ernestomas/SILAR_V1/Planos/03SILAR02.pdf

PARTS LIST
ITEM | QTY | PART NUMBER
1 | 1 | Columna
2 | 2 | Bastidor
3 | 1 | PataBastidor1
4 | 1 | PataBastidor2
5 | 1 | BaseMotorSuperior
6 | 2 | Motor
7 | 1 | Husillo
8 | 1 | GuiaHusillo
9 | 1 | TuercaHusillo
10 | 1 | Deslizador
11 | 1 | BaseEjeDisco
12 | 1 | Disco
13 | 1 | BrazoSoporte
14 | 1 | SeparadorDisco
15 | 1 | BaseMotorInferior
16 | 1 | Rodamiento
17 | 1 | EjeDiscoCentro
18 | 1 | EjeDiscoTope
19 | 1 | EjeDisco
20 | 2 | Pixon
21 | 1 | EjePixyn
22 | 1 | SeguroPixyn
23 | 1 | RuedaDentada
24 | 8 | VarillaTope
25 | 1 | Viker
26 | 8 | SeguroVarilla
27 | 1 | SeguroDisco
28 | 1 | SoportePortaM
29 | 1 | PortaMuestra
30 | 2 | GutaVarilla
31 | 1 | Coupling

PE

Design by | Checked by | Approved by | Date

03 / 31

Type | Sheet Project
