ernestomas/SILAR_V1/Planos/02SILAR02.pdf

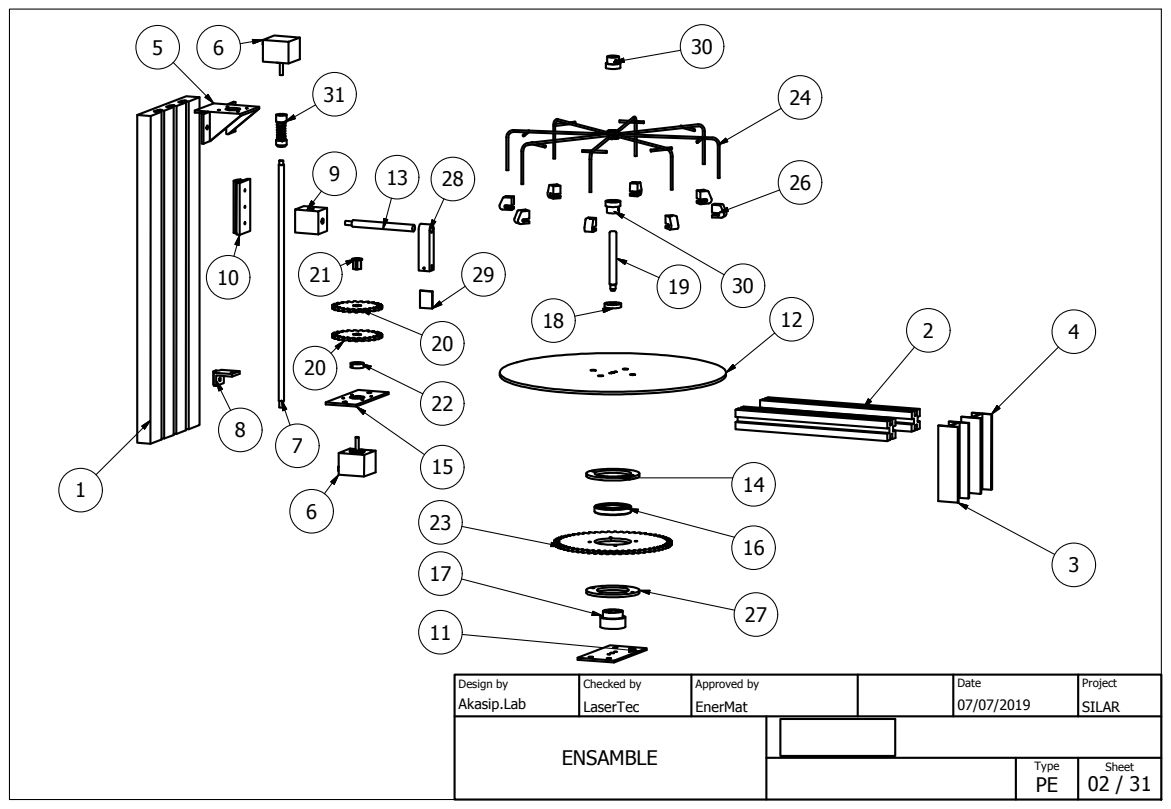
[picture p1: page 1]
ENSAMBLE; Akasip.Lab; LaserTec; Design by; Checked by; Approved by; Date; Type; Sheet; Project; EnerMat; SILAR
