ernestomas/SILAR_V1/Planos/05Bastidor.pdf

250,00

15,00

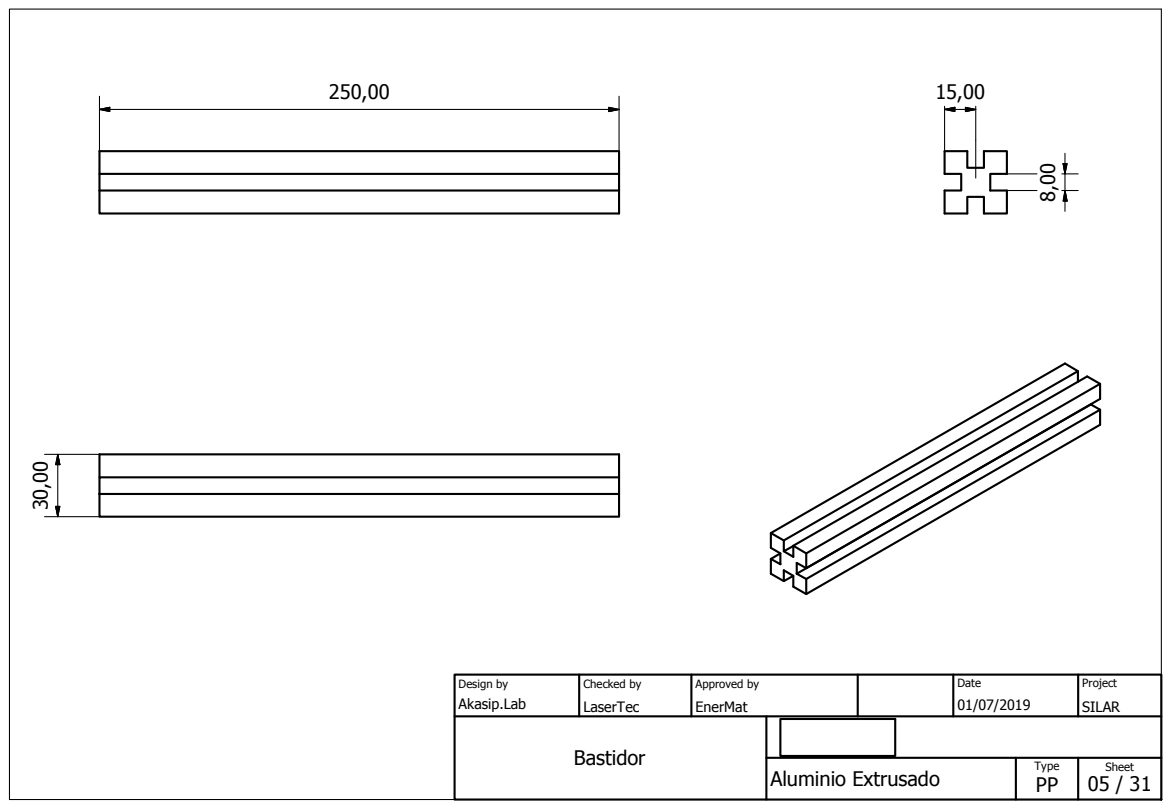
[picture p2: page 1]
Aluminio Extrusado; Bastidor; Akasip.Lab; LaserTec; Design by; Checked by; Approved by; Date; Type; Sheet; Project; EnerMat; SILAR
