ernestomas/SILAR_V1/Planos/06PataBastidorI.pdf

24,00

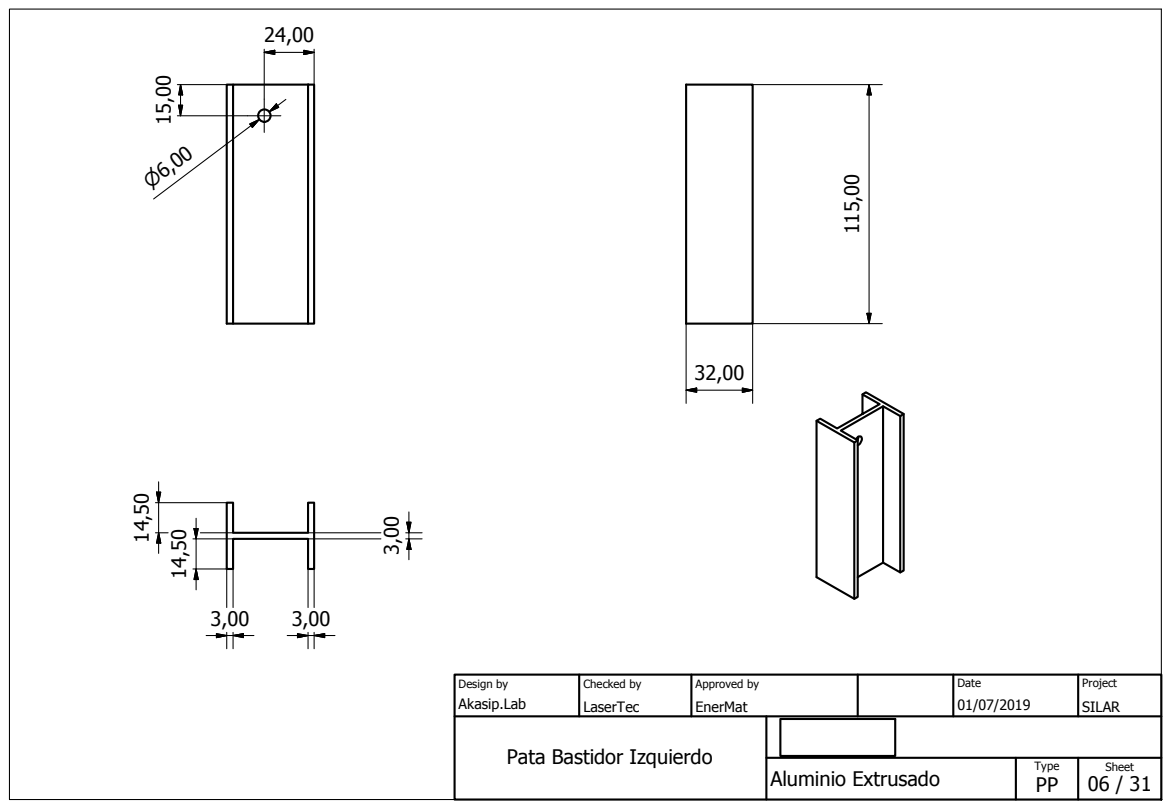
[picture p3: page 1]
Aluminio Extrusado; Akasip.Lab; LaserTec; Design by; Checked by; Approved by; Date; Type; Sheet; Project; EnerMat; SILAR

Pata Bastidor Izquierdo
