ernestomas/SILAR_V1/Planos/08BaseMotorSup.pdf

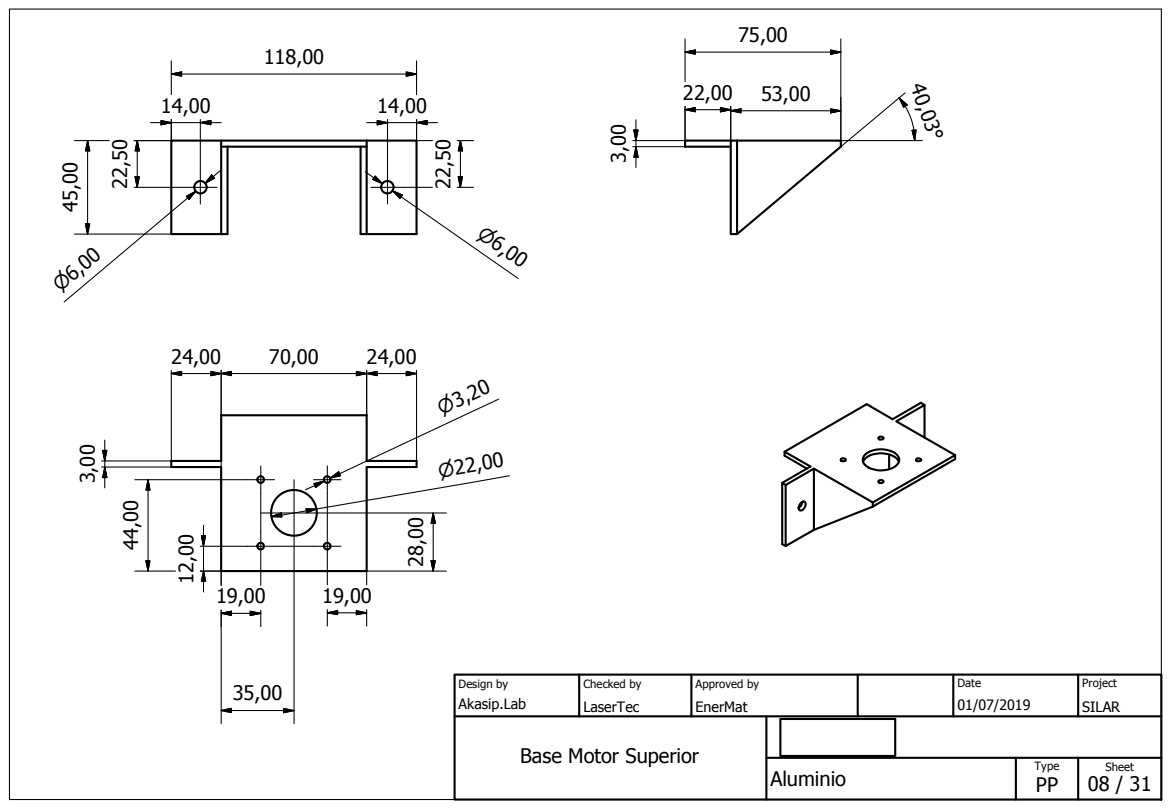
[picture p4: page 1]
Aluminio; Akasip.Lab; LaserTec; Design by; Checked by; Approved by; Date; Type; Sheet; Project; EnerMat; SILAR

Base Motor Superior
