ernestomas/SILAR_V1/Planos/09Motor.pdf

20,00

5,00 | 5,00

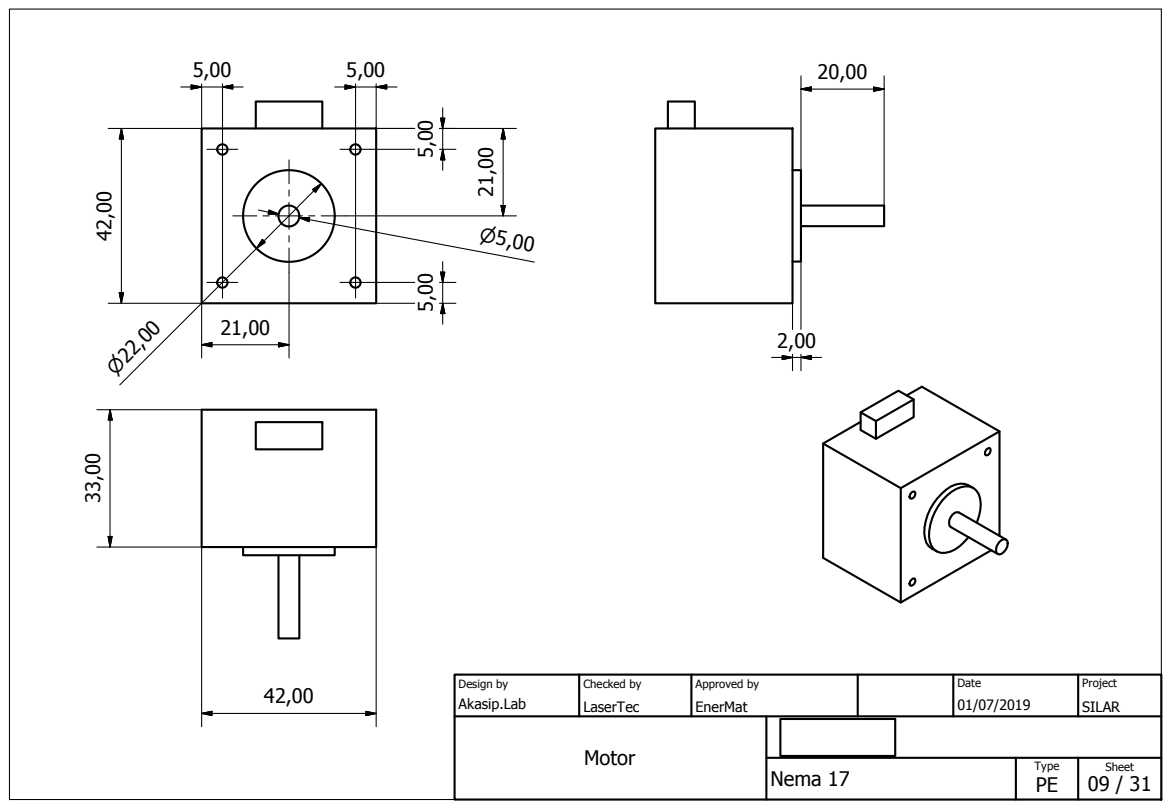
[picture p5: page 1]
Nema 17; Motor; Akasip.Lab; LaserTec; Design by; Checked by; Approved by; Date; Type; Sheet; Project; EnerMat; SILAR
