ernestomas/SILAR_V1/Planos/10Husillo.pdf

376,00

360,00

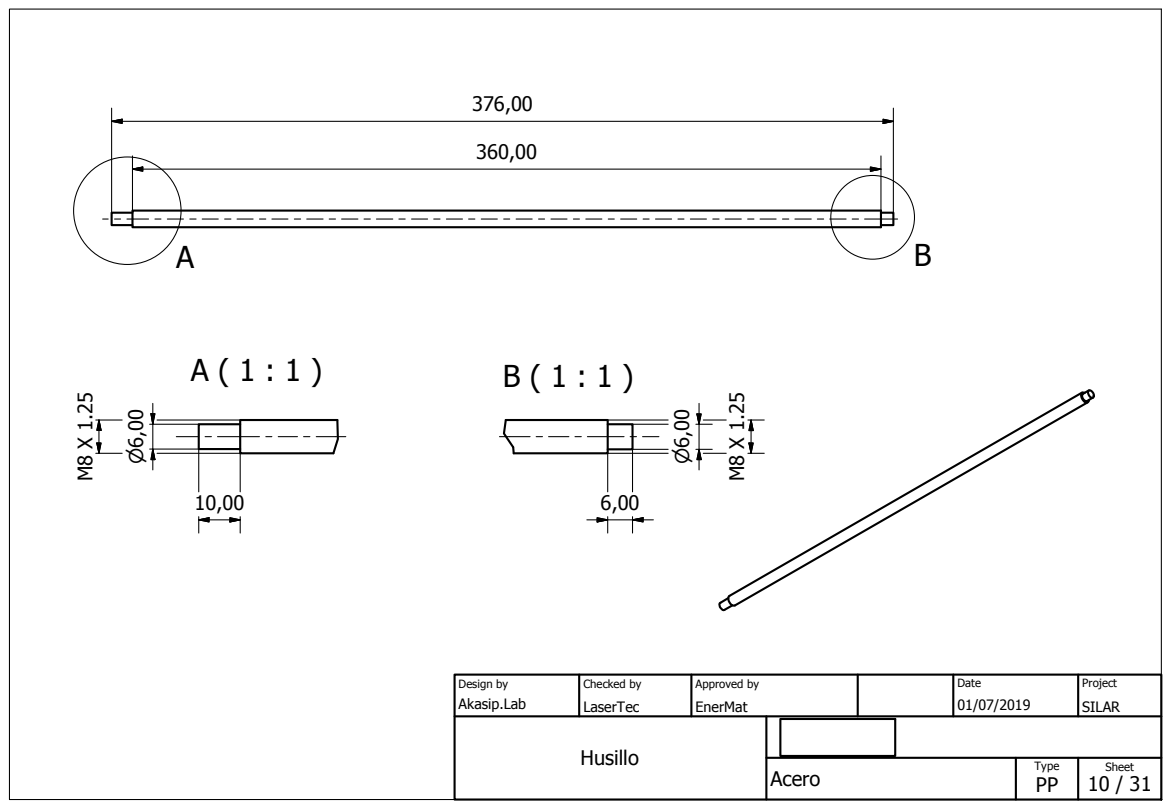
[picture p6: page 1]
Acero; Husillo; Akasip.Lab; LaserTec; Design by; Checked by; Approved by; Date; Type; Sheet; Project; EnerMat; SILAR
