ernestomas/SILAR_V1/Planos/11GuiaHusillo.pdf

35,00

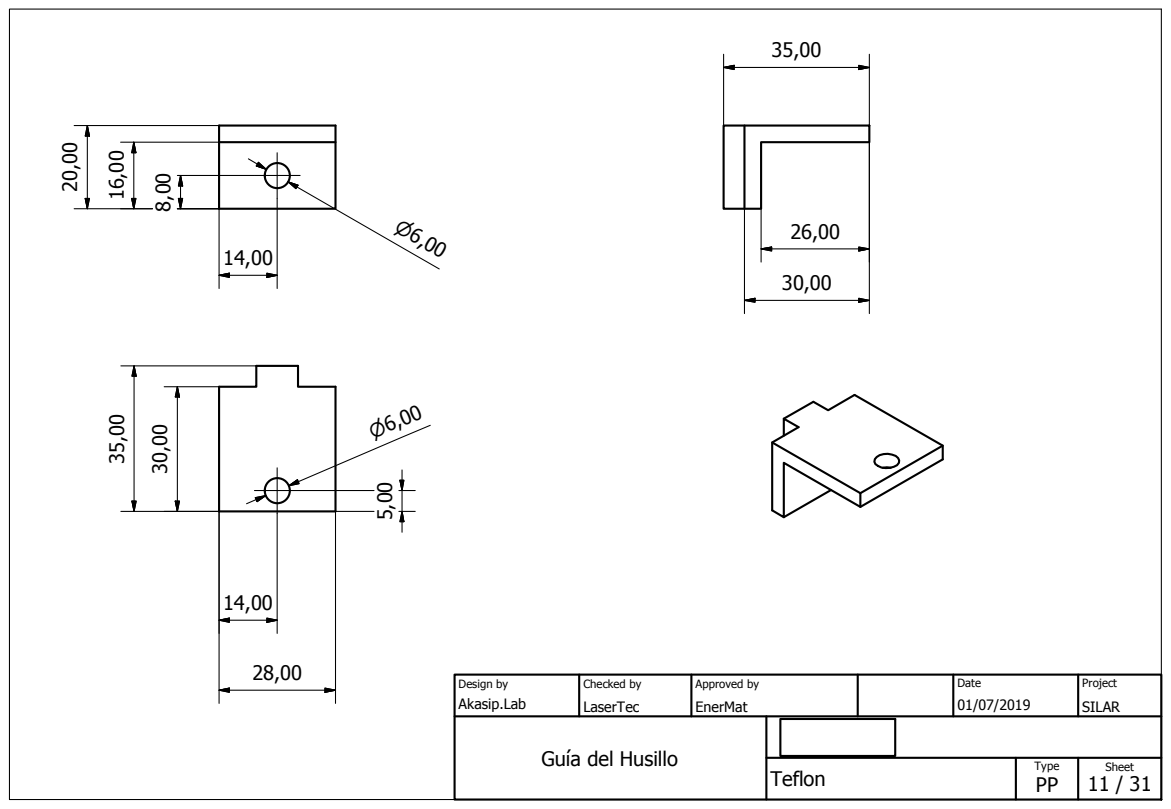
[picture p7: page 1]
Teflon; Akasip.Lab; LaserTec; Design by; Checked by; Approved by; Date; Type; Sheet; Project; EnerMat; SILAR

Guta del Husillo
