ernestomas/SILAR_V1/Planos/12TuercaHusillo.pdf

A-A

B ( 2 : 1 )

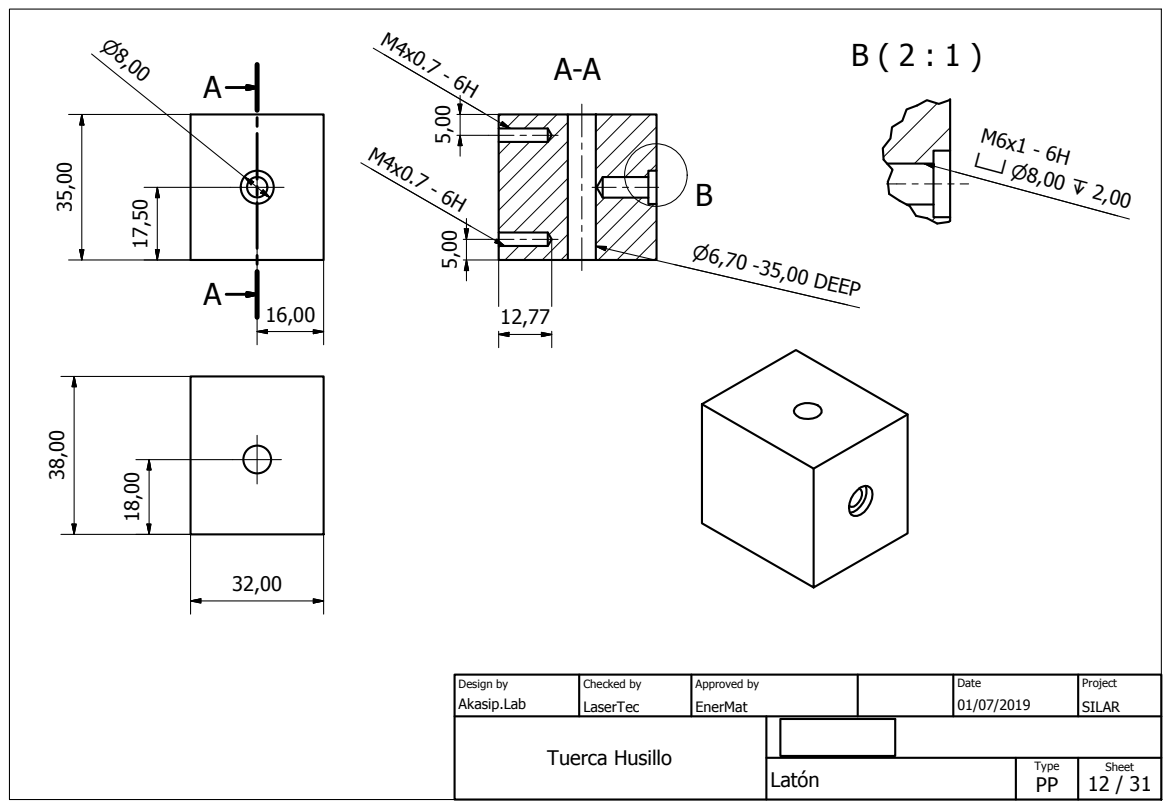
[picture p8: page 1]
Latyn; Tuerca Husillo; Akasip.Lab; LaserTec; Design by; Checked by; Approved by; Date; Type; Sheet; Project; EnerMat; SILAR; P6,70 -35,00 DEEP
