ernestomas/SILAR_V1/Planos/14BaseEjeDisco.pdf

120,00 | 60,00

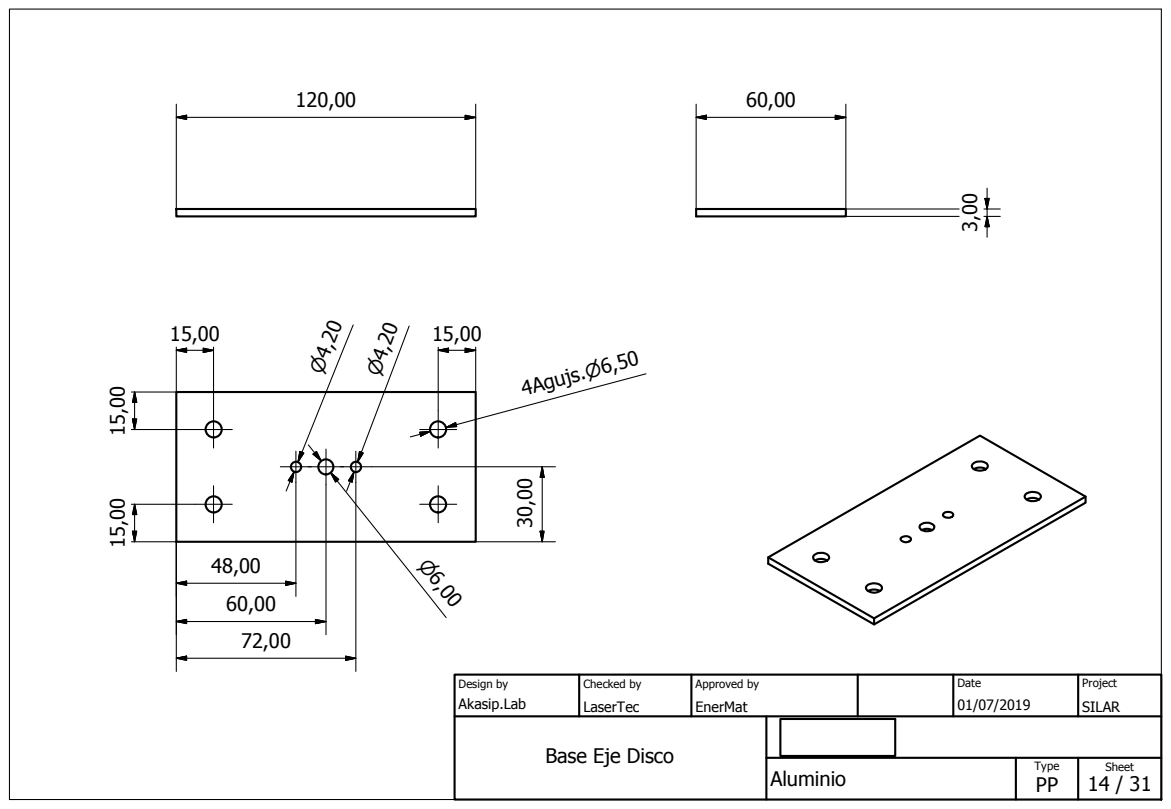
[picture p9: page 1]
Aluminio; Akasip.Lab; LaserTec; Design by; Checked by; Approved by; Date; Type; Sheet; Project; EnerMat; SILAR; P6,50 4Agujs.

Base Eje Disco
