ernestomas/SILAR_V1/Planos/16BrazoSoporte.pdf

112,00

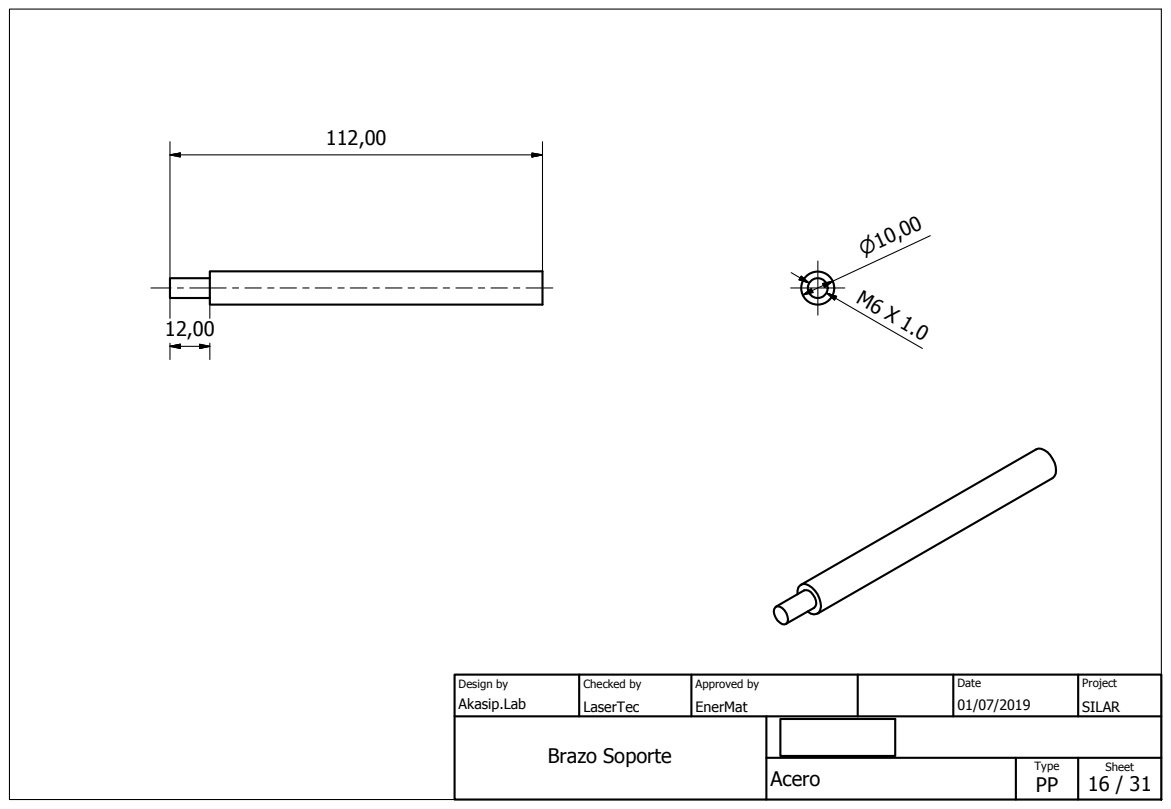
[picture p10: page 1]
Acero; Brazo Soporte; Akasip.Lab; LaserTec; Design by; Checked by; Approved by; Date; Type; Sheet; Project; EnerMat; SILAR
