ernestomas/SILAR_V1/Planos/17SeparadorDisco.pdf

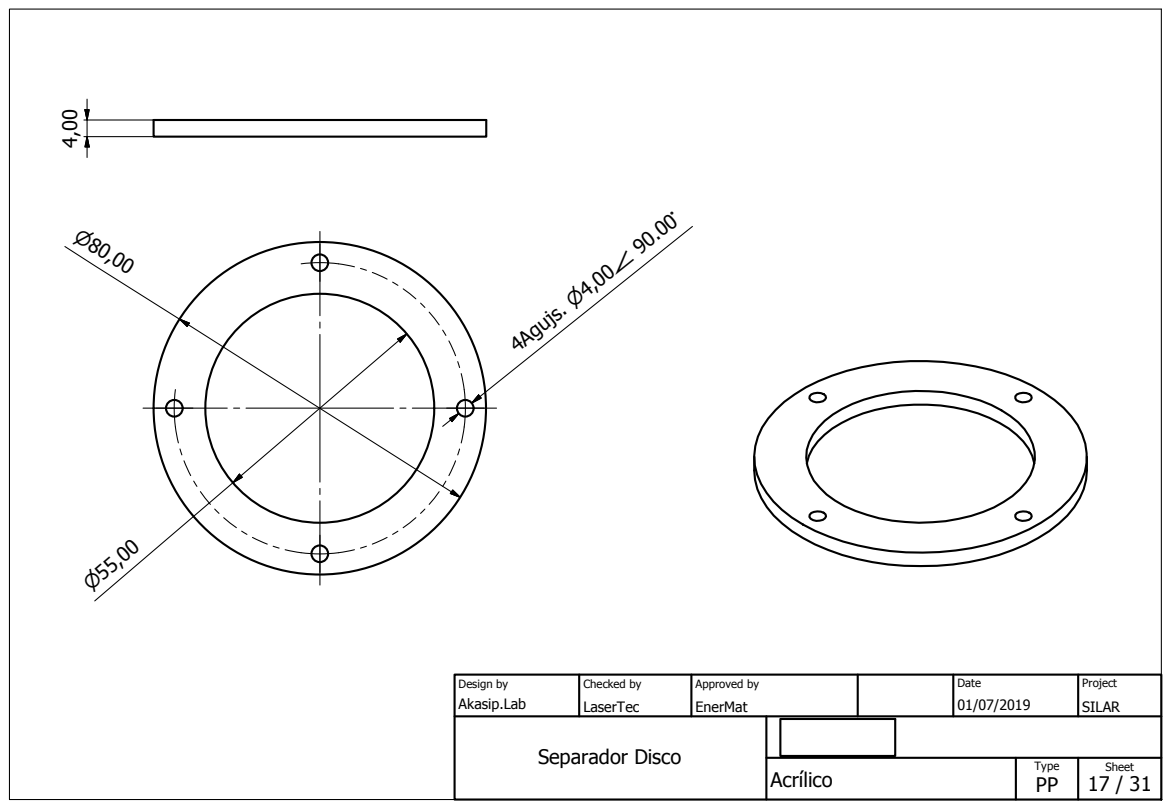
[picture p11: page 1]
Acrtlico; Separador Disco; Akasip.Lab; LaserTec; Design by; Checked by; Approved by; Date; Type; Sheet; Project; EnerMat; SILAR; 4Agujs. C 90.00`
