ernestomas/SILAR_V1/Planos/19EjeDiscoCentro.pdf

A | A-A ( 1 : 1 )

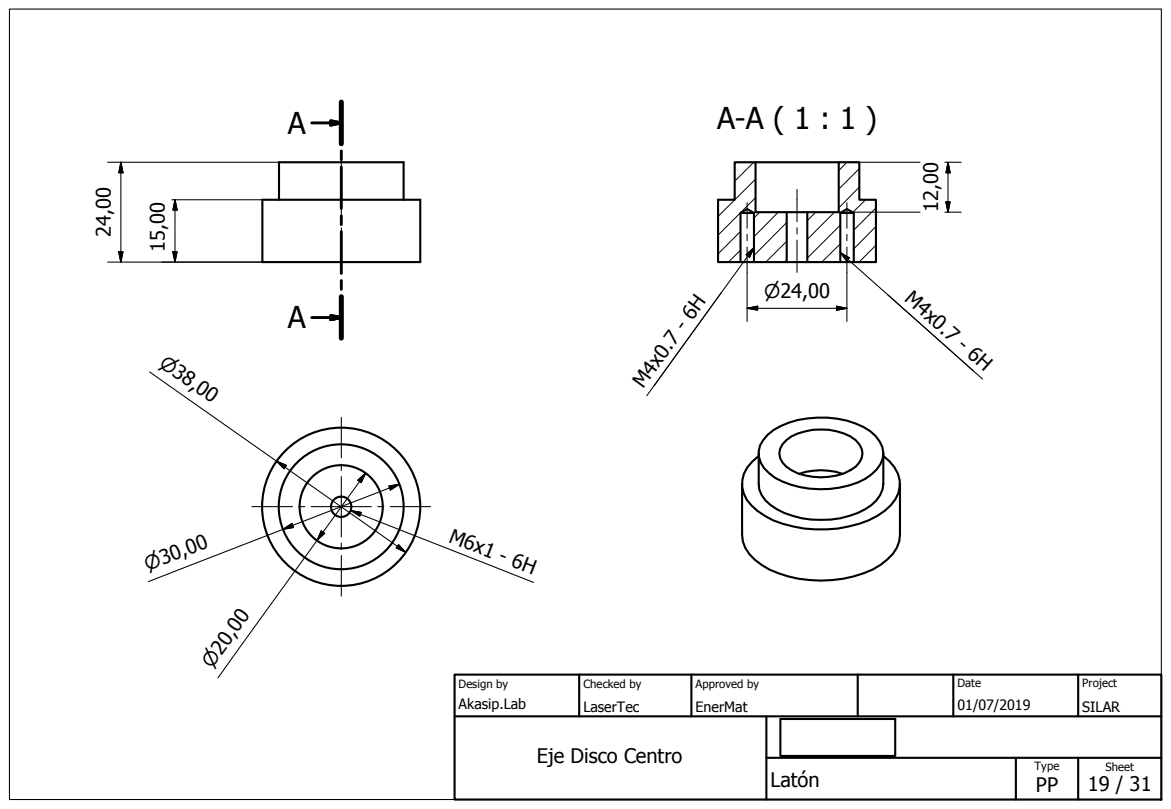
[picture p12: page 1]
Latyn; Akasip.Lab; LaserTec; Design by; Checked by; Approved by; Date; Type; Sheet; Project; EnerMat; SILAR

Eje Disco Centro
