ernestomas/SILAR_V1/Planos/20EjeDiscoTope.pdf

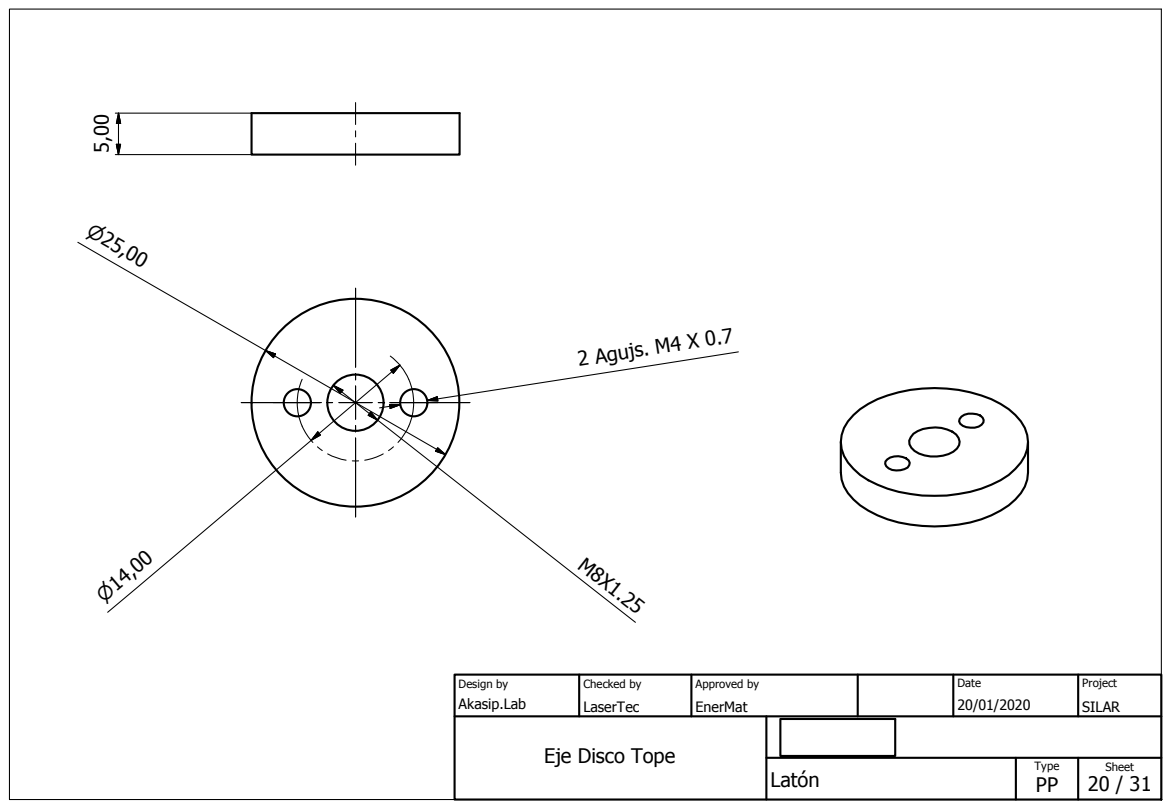
[picture p13: page 1]
Latyn; Akasip.Lab; LaserTec; Design by; Checked by; Approved by; Date; Type; Sheet; Project; EnerMat; SILAR; 2 Agujs. M4 X 0.7

Eje Disco Tope
