ernestomas/SILAR_V1/Planos/22Piñon.pdf

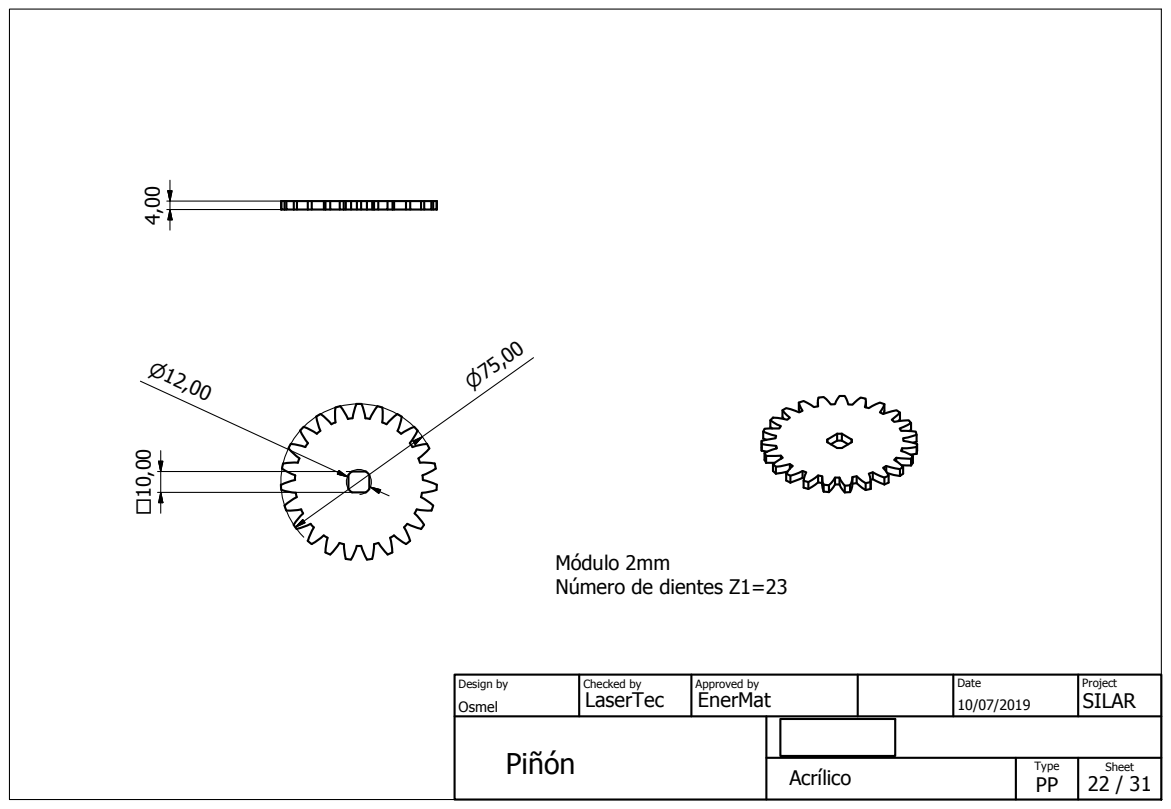
[picture p14: page 1]
Osmel; Design by; Checked by; Approved by; Date; Type; Sheet; Project; LaserTec; EnerMat; SILAR; Pixyn; Acrtlico

Mydulo 2mm
N~mero de dientes Z1=23
