ernestomas/SILAR_V1/Planos/23EjePiñon.pdf

3,00

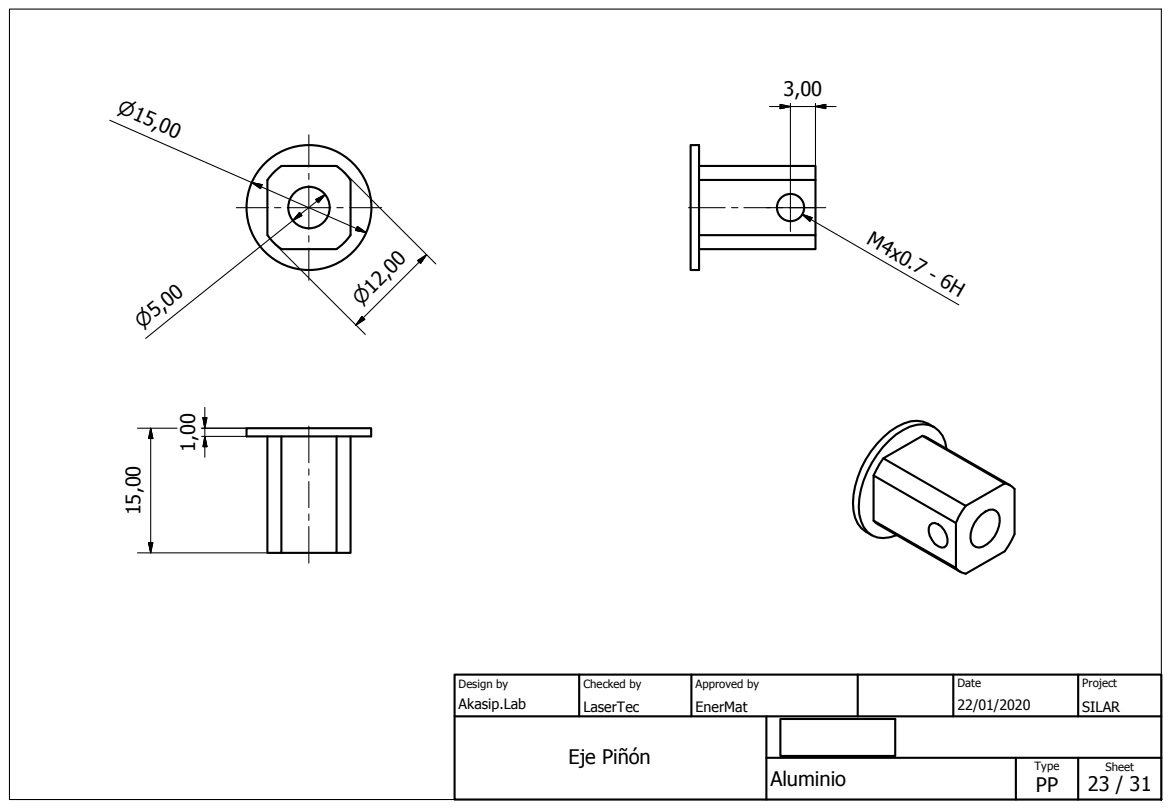
[picture p15: page 1]
Aluminio; Eje Pixyn; Akasip.Lab; LaserTec; Design by; Checked by; Approved by; Date; Type; Sheet; Project; EnerMat; SILAR
