ernestomas/SILAR_V1/Planos/25RuedaDentada.pdf

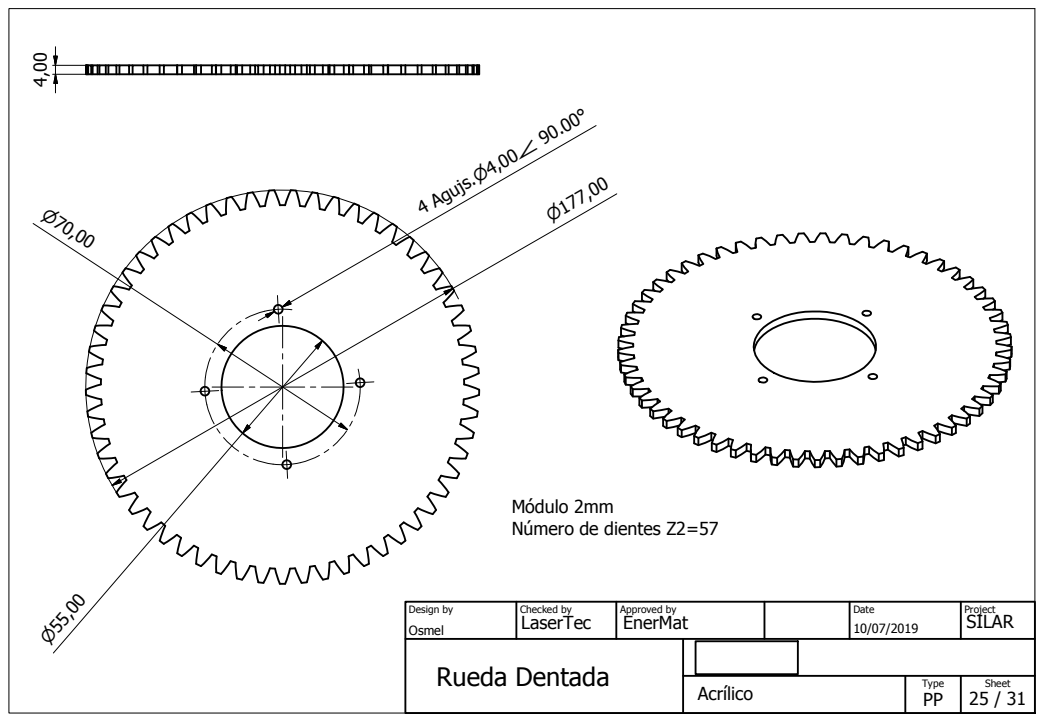
[picture p16: page 1]
Osmel; Design by; Checked by; Approved by; Date; Type; Sheet; Project; 4 Agujs. C 90.00°; LaserTec; EnerMat; SILAR; Rueda Dentada; Acrtlico

Mydulo 2mm
N~mero de dientes Z2=57
