ernestomas/SILAR_V1/Planos/26VarillaTope.pdf

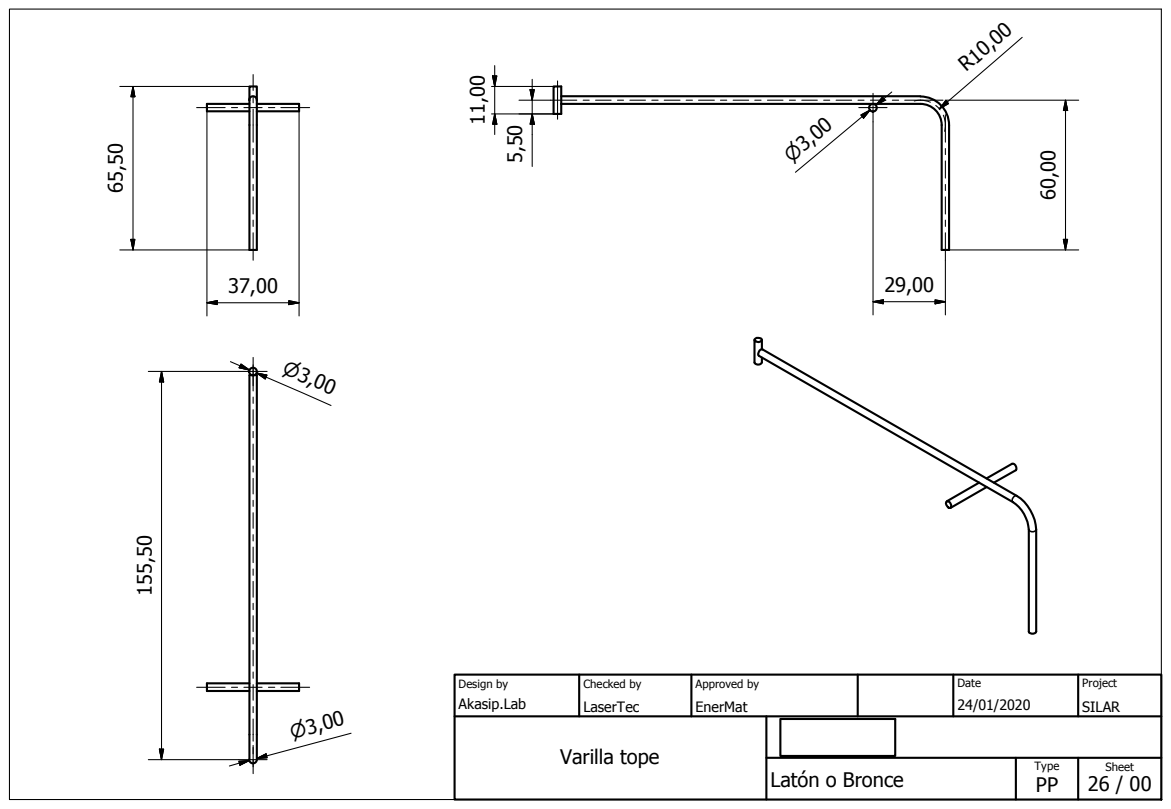
[picture p17: page 1]
Latyn o Bronce; Varilla tope; Akasip.Lab; LaserTec; Design by; Checked by; Approved by; Date; Type; Sheet; Project; EnerMat; SILAR
