ernestomas/SILAR_V1/Planos/27SeguroVarilla.pdf

A-A ( 2 : 1 )

A

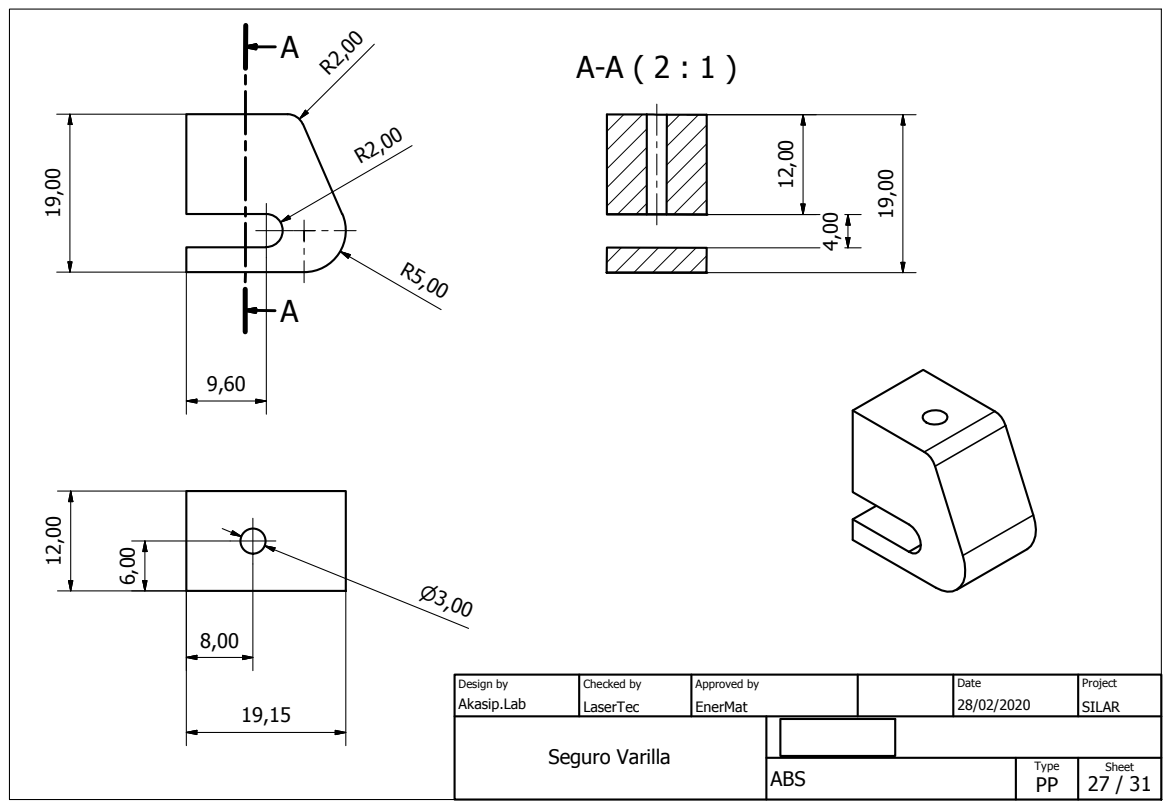
[picture p18: page 1]
ABS; Seguro Varilla; Akasip.Lab; LaserTec; Design by; Checked by; Approved by; Date; Type; Sheet; Project; EnerMat; SILAR
