ernestomas/SILAR_V1/Planos/29SoportePortaM.pdf

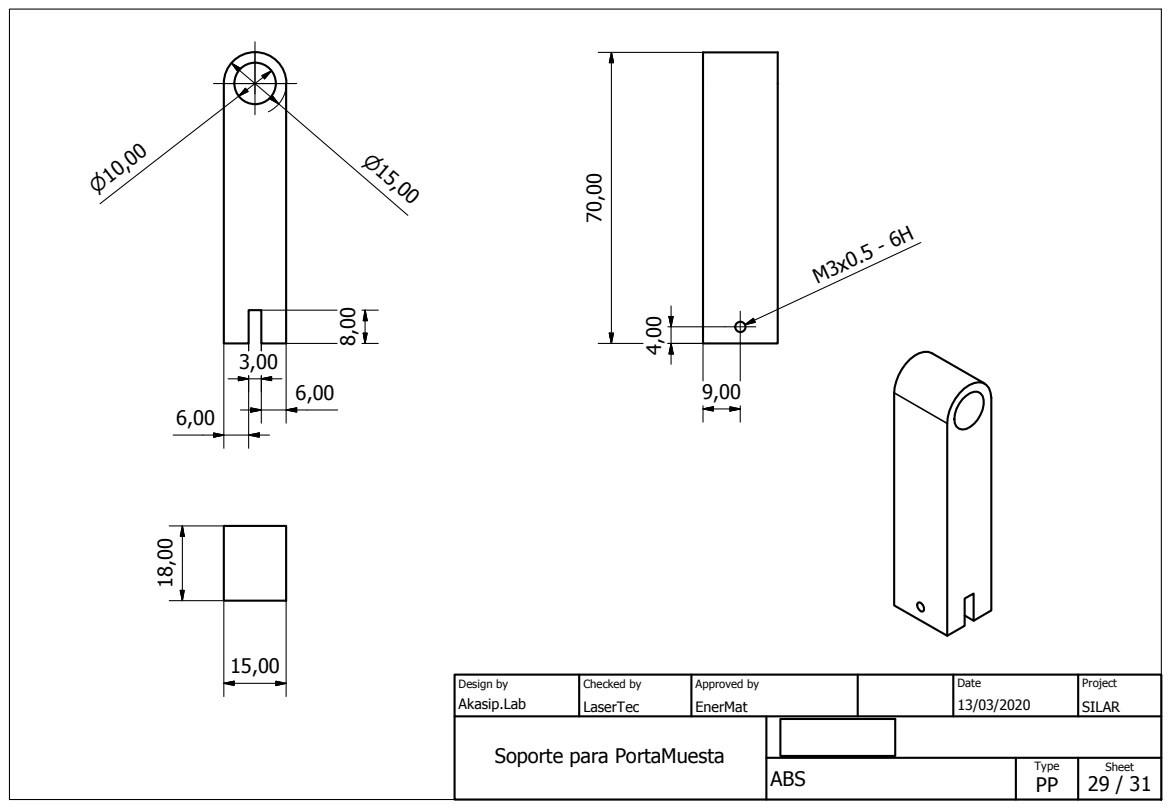
[picture p19: page 1]
ABS; Akasip.Lab; LaserTec; Design by; Checked by; Approved by; Date; Type; Sheet; Project; EnerMat; SILAR

Soporte para PortaMuesta
