ernestomas/SILAR_V1/Planos/30GuiaVarilla.pdf

A-A ( 2 : 1 )

A

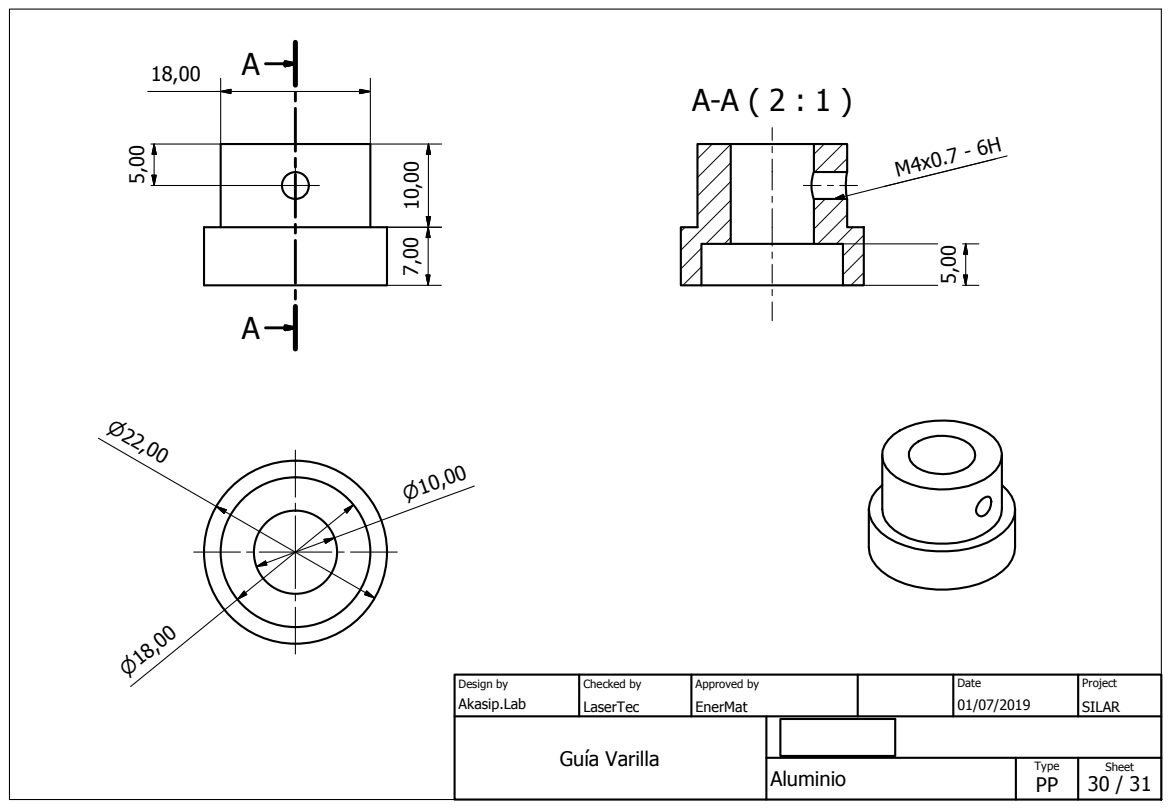
[picture p20: page 1]
Aluminio; Guta Varilla; Akasip.Lab; LaserTec; Design by; Checked by; Approved by; Date; Type; Sheet; Project; EnerMat; SILAR
