ernestomas/SILAR_V1/Planos/311CouplingSp.pdf

A-A ( 2 : 1 )
A

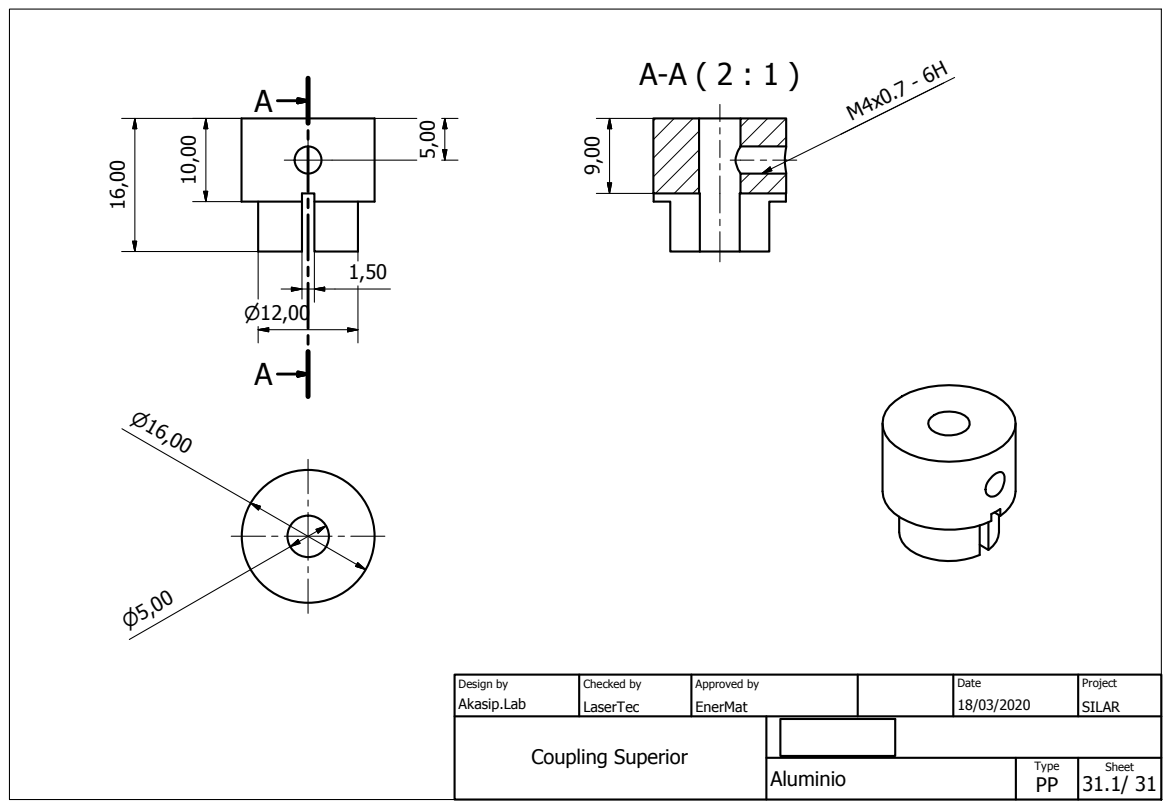
[picture p21: page 1]
Aluminio; Coupling Superior; Akasip.Lab; LaserTec; Design by; Checked by; Approved by; Date; Type; Sheet; Project; EnerMat; SILAR
