ernestomas/SILAR_V1/Planos/312CouplingIn.pdf

A-A ( 2 : 1 )

A

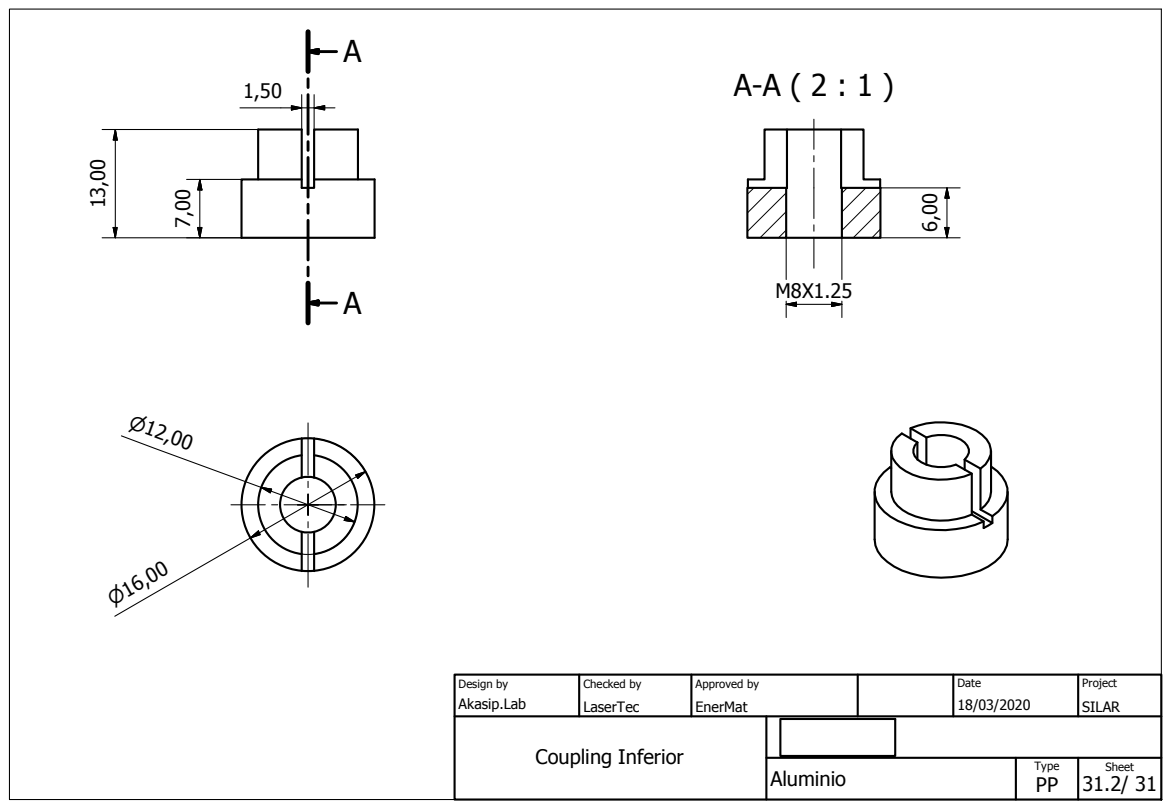
[picture p22: page 1]
Aluminio; Coupling Inferior; Akasip.Lab; LaserTec; Design by; Checked by; Approved by; Date; Type; Sheet; Project; EnerMat; SILAR
