ernestomas/SILAR_V1/Planos/31Coupling.pdf

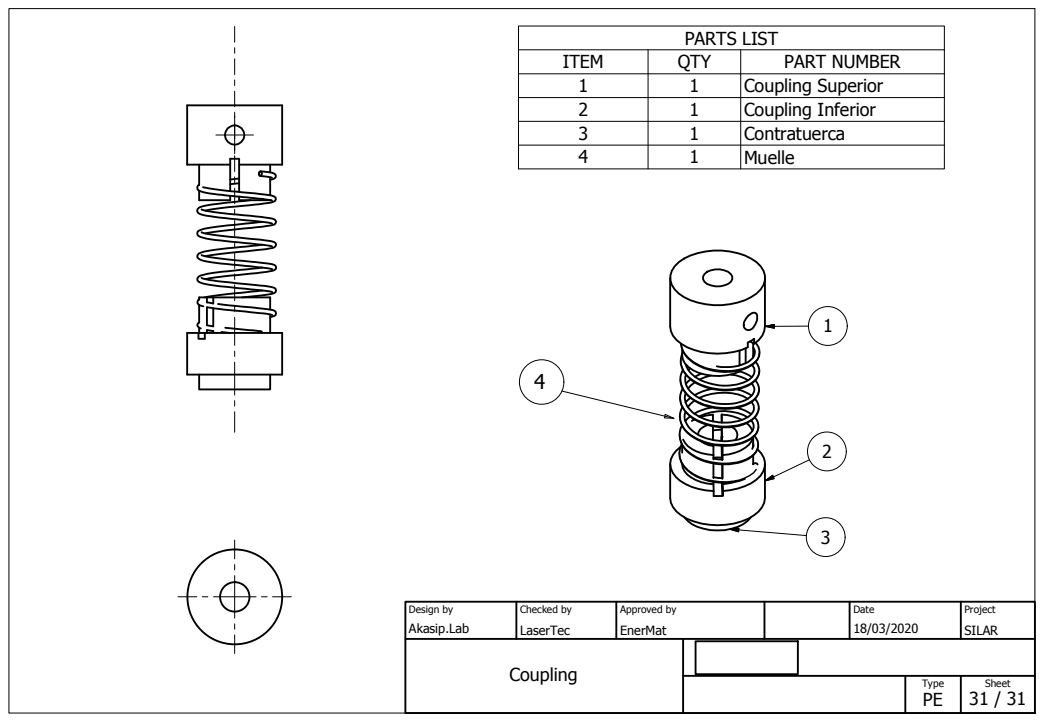
[picture p23: page 1]
PARTS LIST; ITEM; QTY; PART NUMBER; Coupling Superior; Coupling Inferior; Contratuerca; Muelle; Coupling; Akasip.Lab; LaserTec; Design by; Checked by; Approved by; Date; Type; Sheet; Project; EnerMat; SILAR
