ernestomas/SILAR_V1/Planos/01SILAR01.pdf

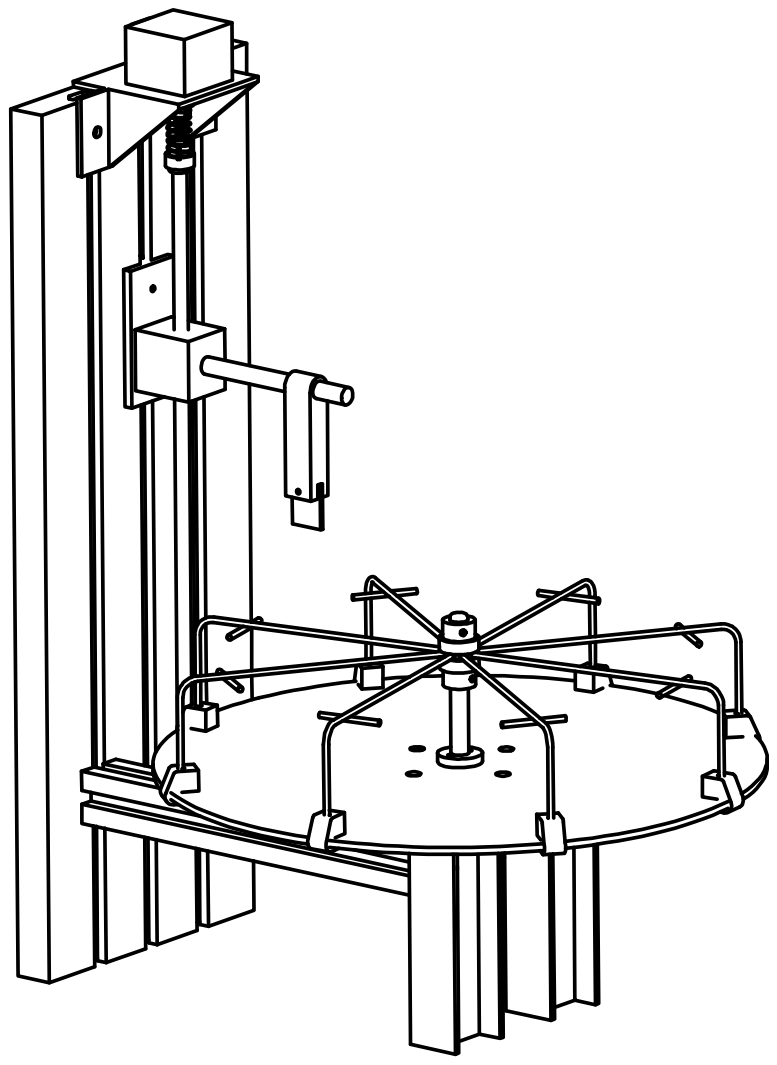
[picture p24: page 1]
