ernestomas/SILAR_V1/Planos/13Deslizador.pdf

10,00 | 79,00

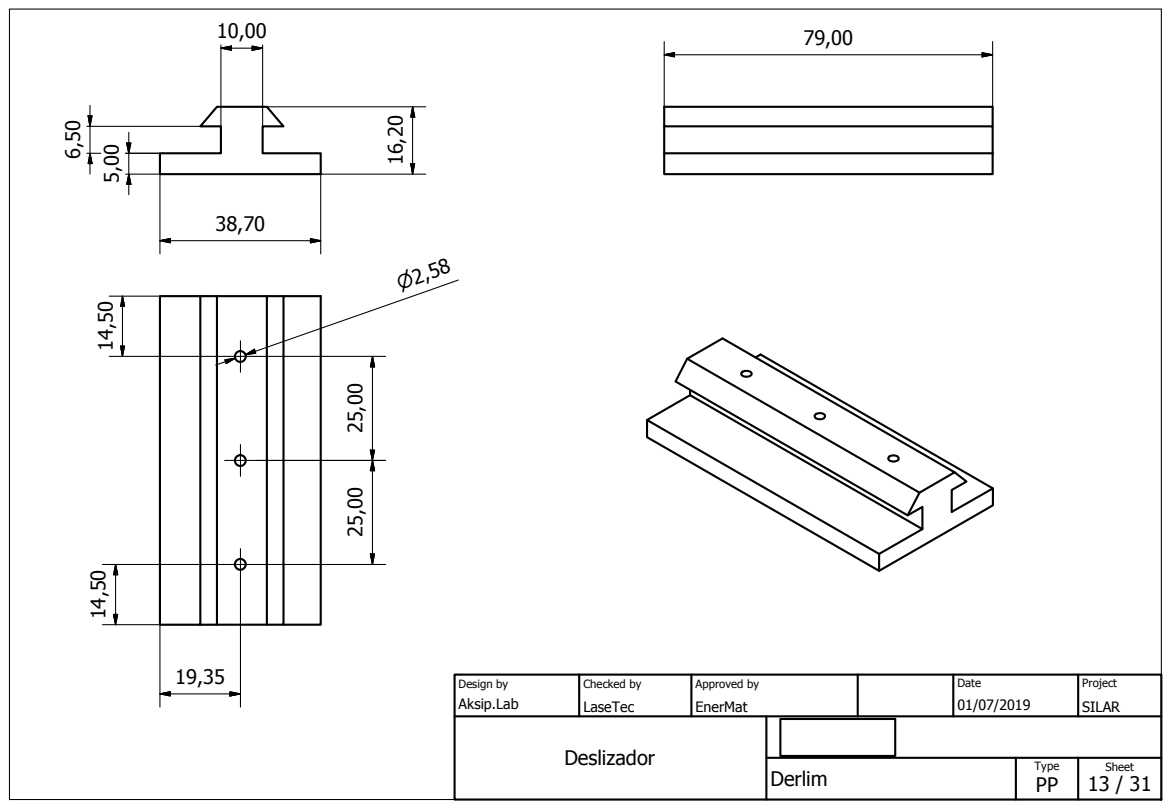
[picture p25: page 1]
Derlim; Deslizador; Aksip.Lab; LaseTec; Design by; Checked by; Approved by; Date; Type; Sheet; Project; EnerMat; SILAR
