ernestomas/SILAR_V1/Planos/15Disco.pdf

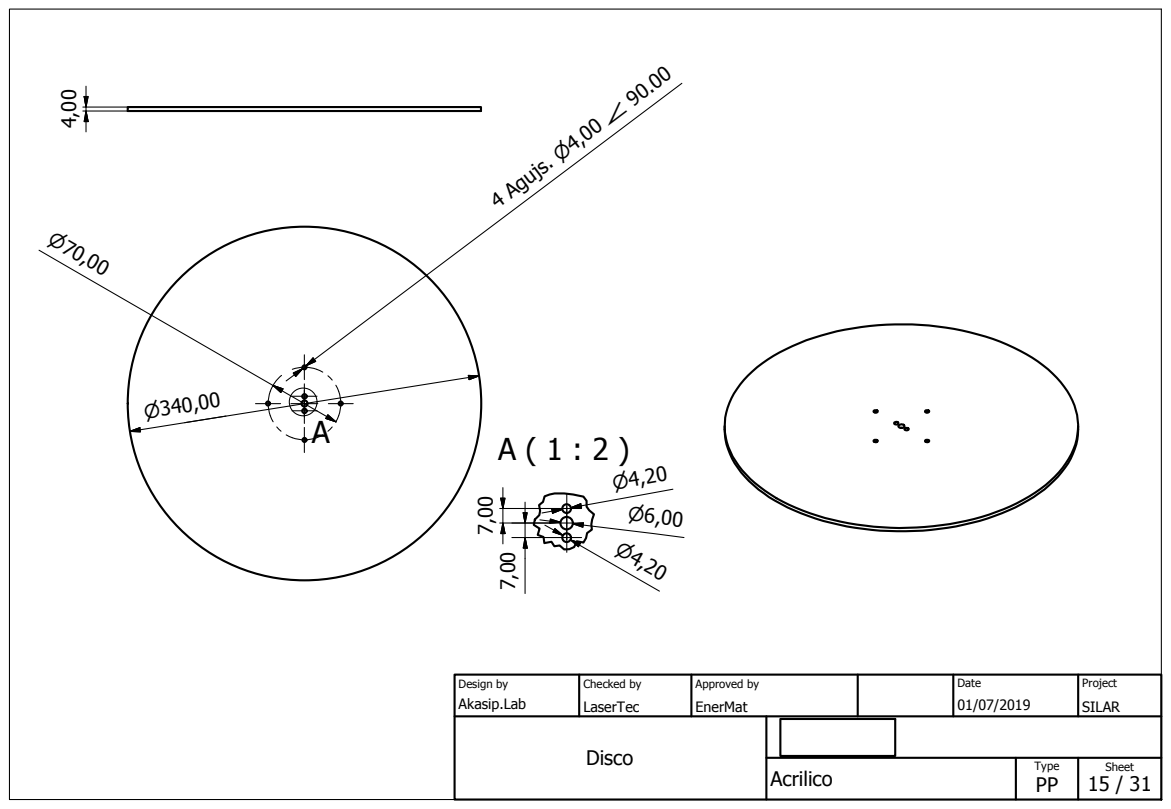
[picture p26: page 1]
ili; 4 Agujs.
